AstroKey/astrokey_hardware/README.md

# astrokey_hardware
AstroKey hardware repository
