AstroKey/astrokey_hardware/boards/AstroKey/AstroKey.brd

## EAGLE design boards/AstroKey/AstroKey.brd (2018-02-04)

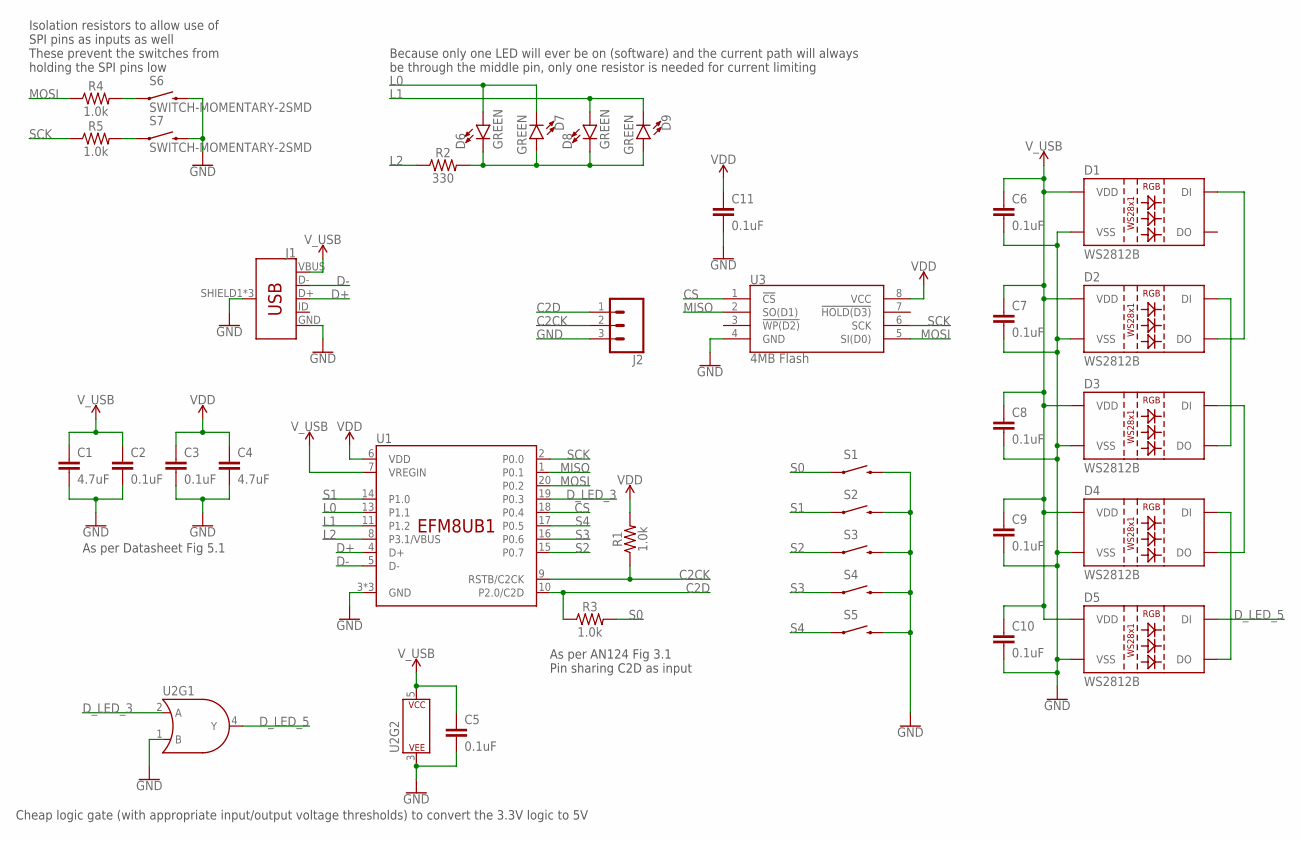
[picture p1: schematic AstroKey.sch]

Parts:
C1, C4: 4.7uF; 0402
C2, C3, C5, C6, C7, C8, C9, C10, C11: 0.1uF; 0402
D1, D2, D3, D4, D5: WS2812B
D6, D7, D8, D9: GREEN; LED-0603
J1: USB_MICRO-B_FEMALE-SMT; USB-B-MICRO-SMD
J2: CONN_031X03_NO_SILK; 1X03_NO_SILK
R1, R3, R4, R5: 1.0k; 0402
R2: 330; 0402
S1, S2, S3, S4, S5: MOMENTARY-SWITCH-SPST-SOCKET-SMD-CHERRY; CHERRY-MX-SOCKET
S6, S7: SWITCH-MOMENTARY-2SMD; TACTILE-SWITCH-SMD
U1: EFM8UB1; SILABS-QFN20
U2: 74AHC1G32GW; SOT353; PARTNO MC74VHC1GT32
U3: 4MB Flash; SO08

Connections:
C2CK: J2.2, R1.1, U1.9 (RSTB/C2CK)
C2D: J2.1, R3.1, U1.10 (P2.0/C2D)
CS: U1.18 (P0.4), U3.1 (!CS)
D+: J1.D+, U1.4 (D+)
D-: J1.D-, U1.5 (D-)
D_LED_3: U1.19 (P0.3), U2.2 (A)
D_LED_5: D5.4 (DI), U2.4 (Y)
GND: C1.2, C2.2, C3.2, C4.2, C5.2, C6.2, C7.2, C8.2, C9.2, C10.2, C11.2, D1.3 (VSS), D2.3 (VSS), D3.3 (VSS), D4.3 (VSS), D5.3 (VSS), J1.GND, J1.SHIELD1 (SHIELD), J1.SHIELD2 (SHIELD), J1.SHIELD3 (SHIELD), J2.3, S1.2, S2.2, S3.2, S4.2, S5.2, S6.3 (2), S7.3 (2), U1.3 (GND), U1.12 (GND), U1.21 (GND), U2.1 (B), U2.3 (P$V-), U3.4 (GND)
L0: D6.A, D7.C, U1.13 (P1.1)
L1: D8.A, D9.C, U1.11 (P1.2)
L2: R2.1, U1.8 (P3.1/VBUS)
MISO: U1.1 (P0.1), U3.2 (SO(D1))
MOSI: R4.1, U1.20 (P0.2), U3.5 (SI(D0))
unnamed: D4.4 (DI), D5.2 (DO)
unnamed: D6.C, D7.A, D8.C, D9.A, R2.2
unnamed: D3.4 (DI), D4.2 (DO)
unnamed: D2.4 (DI), D3.2 (DO)
unnamed: D1.4 (DI), D2.2 (DO)
unnamed: R4.2, S6.1
unnamed: R5.2, S7.1
S0: R3.2, S1.1
S1: S2.1, U1.14 (P1.0)
S2: S3.1, U1.15 (P0.7)
S3: S4.1, U1.16 (P0.6)
S4: S5.1, U1.17 (P0.5)
SCK: R5.1, U1.2 (P0.0), U3.6 (SCK)
VDD: C3.1, C4.1, C11.1, R1.2, U1.6 (VDD), U3.8 (VCC)
V_USB: C1.1, C2.1, C5.1, C6.1, C7.1, C8.1, C9.1, C10.1, D1.1 (VDD), D2.1 (VDD), D3.1 (VDD), D4.1 (VDD), D5.1 (VDD), J1.VBUS, U1.7 (VREGIN), U2.5 (P$V+)

Notes on the sheet:
As per AN124 Fig 3.1 Pin sharing C2D as input
As per Datasheet Fig 5.1
Cheap logic gate (with appropriate input/output voltage thresholds) to convert the 3.3V logic to 5V
Because only one LED will ever be on (software) and the current path will always be through the middle pin, only one resistor is needed for current limiting
Isolation resistors to allow use of SPI pins as inputs as well These prevent the switches from holding the SPI pins low

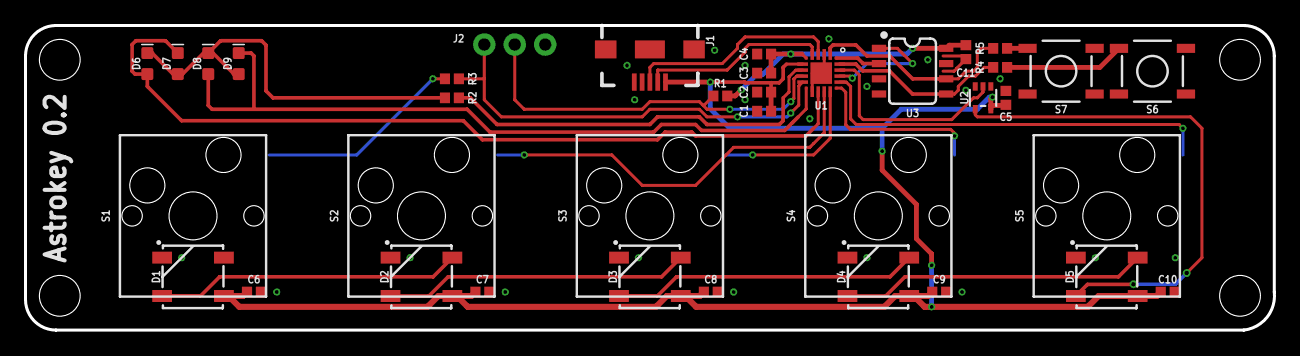
[picture p2: board AstroKey.brd from above]

Board: 2 copper layers, 104.2 x 25.4 mm, 37 parts (0 on the bottom side), 28 nets.
