AstroKey/astrokey_hardware/(threads)

Thread 1 (2018-01-15):

PCB Revisions

aeksco, 2018-01-15:
- Elongate boards
- Add screw holes by edges
- Round corners
- Add footprint for switch sockets
- Add SMD LEDs under switches
- Flash memory
- Add ESD protection
- Silkscreen Rev. number
- Silkscreen `AstroKey 2018`
- Silkscreen Logo
- SMD pads for USB connection

Closed 2018-02-04.
