AstroKey/astrokey_hardware/(commit log)

2017-10-24 Initial board layout done, traces unrouted
    [AstroKey.brd, AstroKey.sch]
2017-10-27 Finished first version of board
    [AstroKey.brd, AstroKey.sch]
2017-12-17 Uploaded Eagle cam file for gerber generation
2018-01-28 Board revision 0.2
    Changed board shape
    Added screw holes to board corners
    Moved USB connector to top of board
    Added SPI Flash IC
    Changed keyswitch footprint to use sockets
    Added layer LEDs and buttons
    Added RGB LEDs under keys (WS2812b)
    Added silkscreen of "Astrokey" and board revision number
    [AstroKey.brd, AstroKey.sch]
2018-01-28 Connected CS pin to MCU (no revision number increment)
    [AstroKey.brd, AstroKey.sch]
2018-01-28 Fixed error in comment in schematic
    [AstroKey.sch]
2018-01-28 Aligned C1 with C2 C3 C4 (no revision number increment)
    [AstroKey.brd]
2018-01-28 Fixed part number of OR gate
    [AstroKey.brd, AstroKey.sch]
2018-02-03 Fixed label positions on L0 and L1 nets
    [AstroKey.sch]
